lipoyang/Kompacto/(list of files, cad)

Other CAD files:
mech/Kompacto_v50.f3d
