lipoyang/Kompacto/mech/Kompacto.pdf

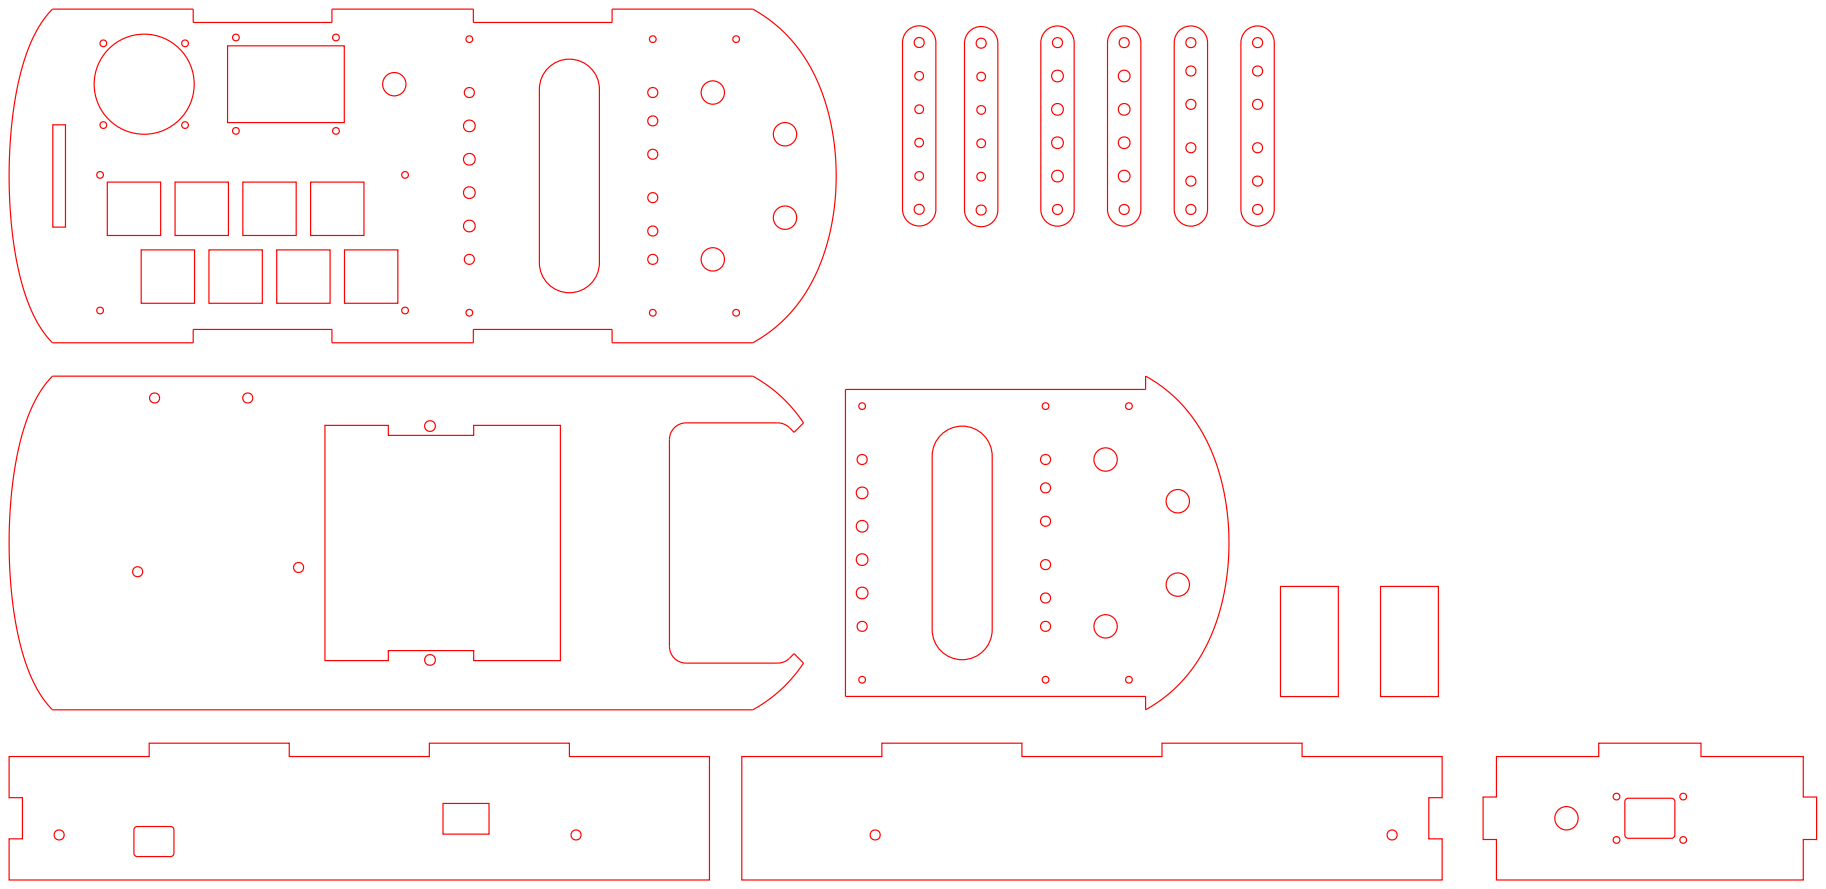
[picture p5: page 1]
