lipoyang/Kompacto/src/main/SwEncoder.h

#pragma once

#include <stdbool.h>

// スイッチ付きロータリーエンコーダ
class SwEncoder{
public:
    void begin(int pinA, int pinB, int pinSW = -1);
    void update();
    void reset();
    int  readCount();
    int  readDiff();
    bool isPressed();
    bool wasReleased();
    bool wasLongPushed();
    static void isr(SwEncoder *encoder);
private:
    int _pinA;
    int _pinB;
    int _pinSW;
    bool _has_sw;
    int _cnt;
    int _cnt_prev;
    bool _sw_prev;
    bool _wasReloased;
    bool _initializing;
    bool _wasLongPushed;
    bool _wasLongPushed2;
    uint32_t _t_pushed;
    uint32_t _t_last;
};
