lipoyang/Kompacto/(commit log)

2024-12-04 add OLED display and rotary encoder
2025-01-31 add mech design data
    [Kompacto v50.f3d]
2025-01-31 rename a file
    [Kompacto_v50.f3d]
